NAIT-CNT-CMPE2750-1241-A02/SimonDemos/README.md

# SimonDemos
Demos used in this course, including the sample project.
