NAIT-CNT-CMPE2750-1241-A02/SimonDemos/design/pcb_design/die_roller_schematic.pdf

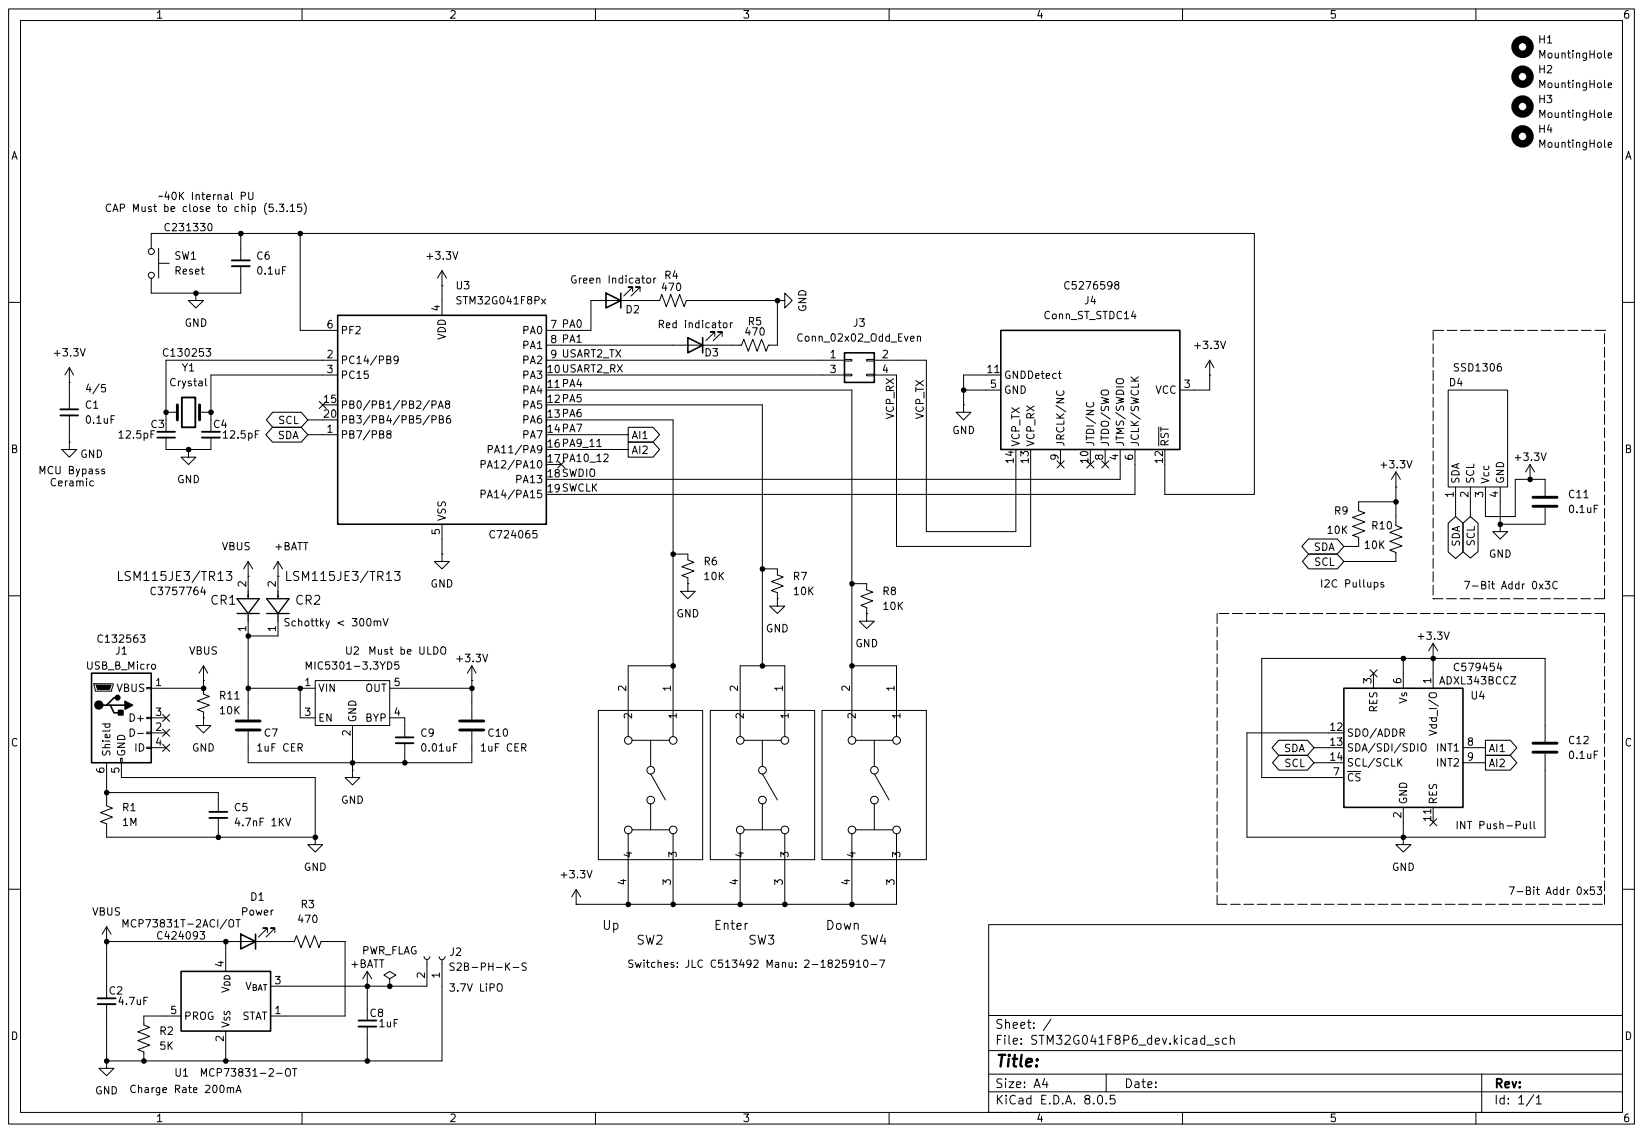
[picture p1: page 1]
