NAIT-CNT-CMPE2750-1241-A02/SimonDemos/design/pcb_design/STM32G041F8P6_dev.kicad_pcb

## KiCad design design/pcb_design/STM32G041F8P6_dev.kicad_pcb (2024-11-06)

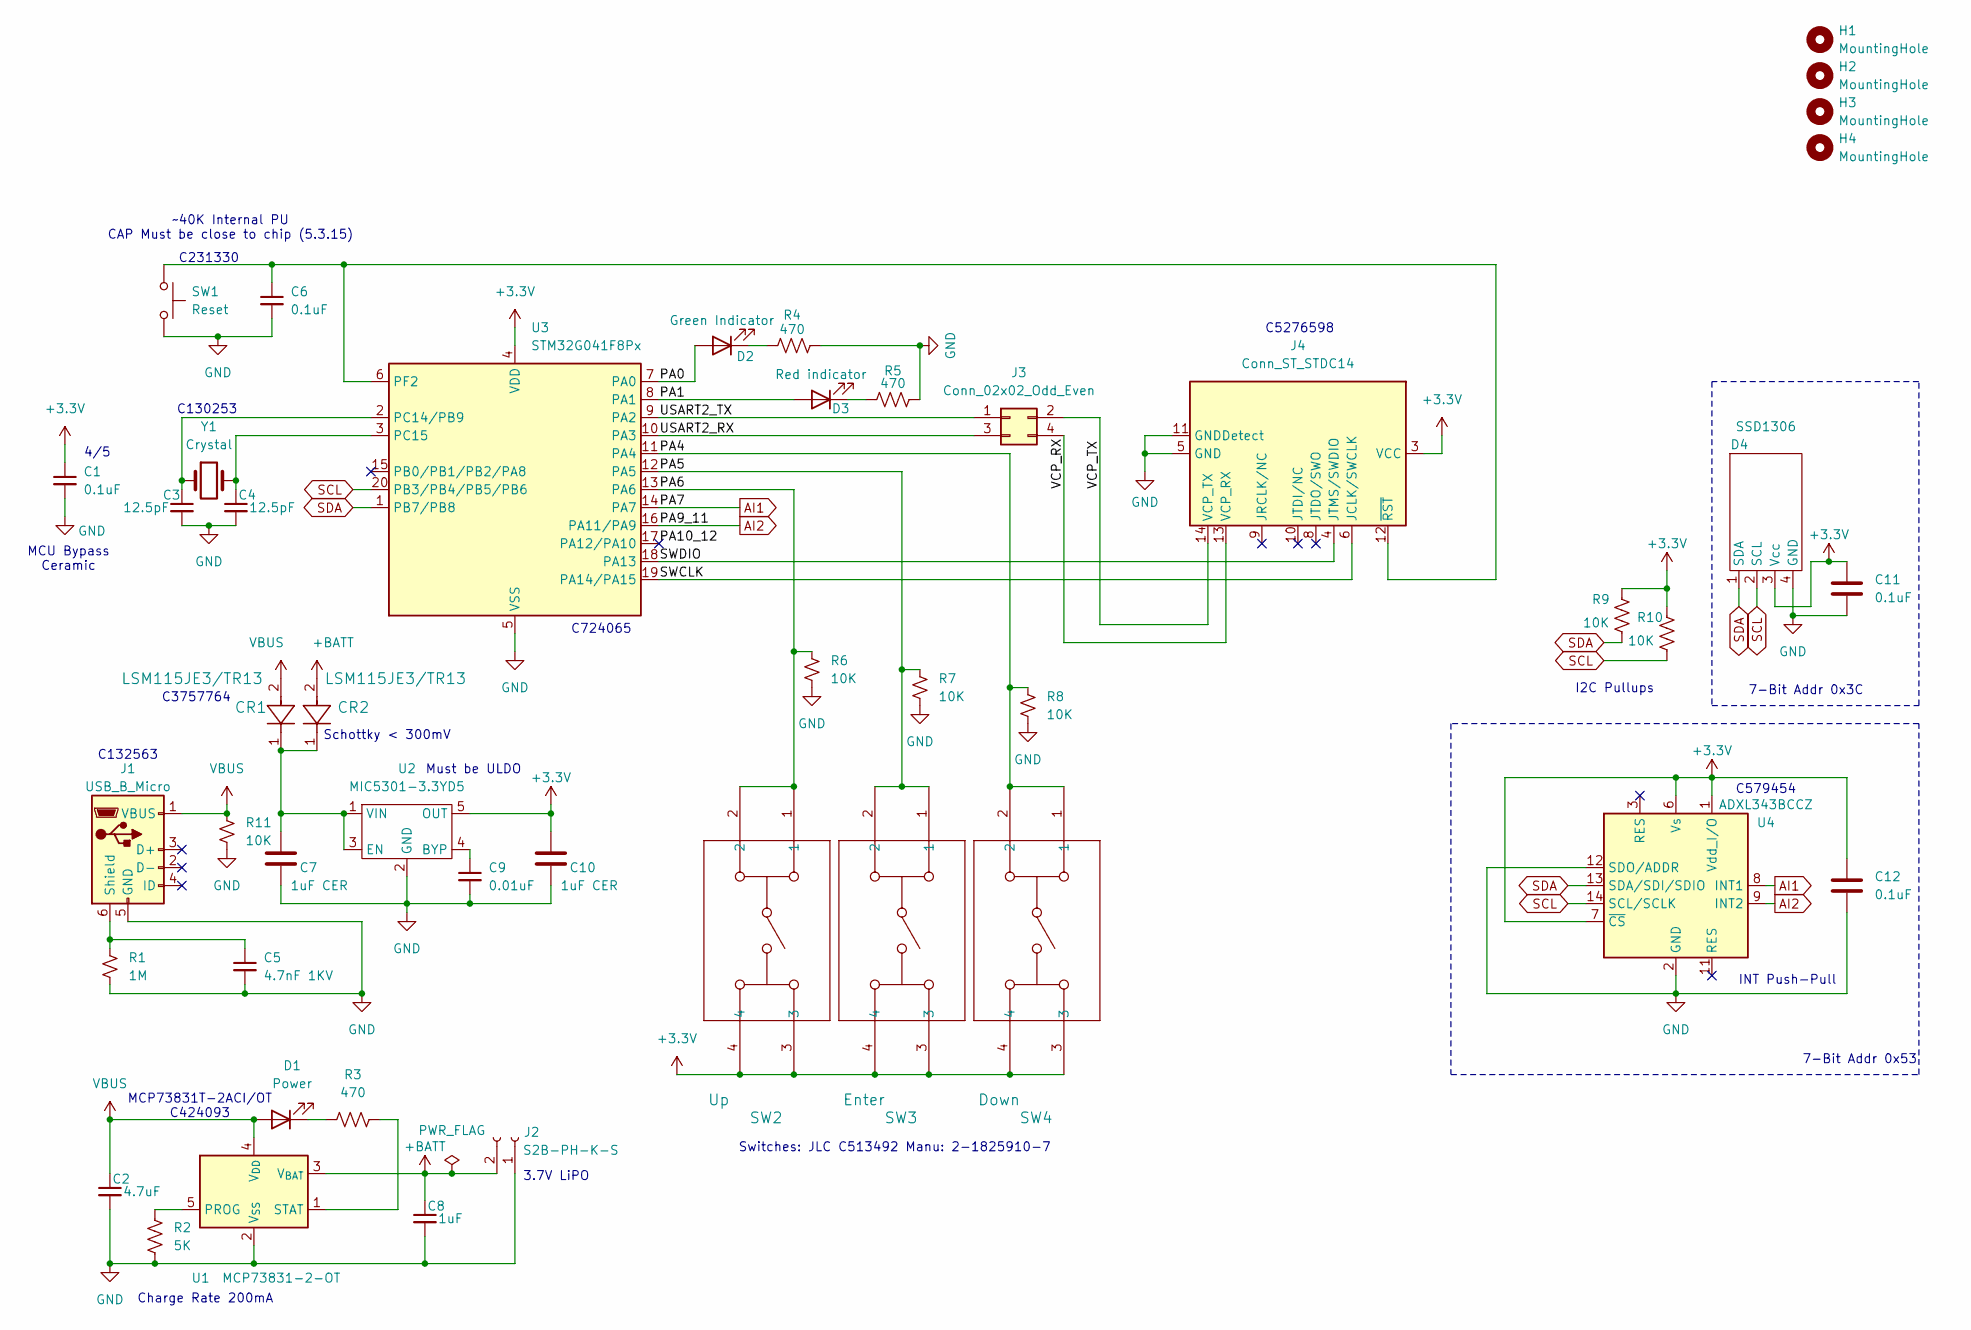
[picture p2: schematic STM32G041F8P6_dev.kicad_sch]

Parts:
C1, C6, C11, C12: 0.1uF; C_0603_1608Metric
C2: 4.7uF; C_1206_3216Metric
C3, C4: 12.5pF; C_0603_1608Metric
C5: 4.7nF 1KV; C_0805_2012Metric
C7, C10: 1uF CER; C_1206_3216Metric
C8: 1uF; C_1206_3216Metric
C9: 0.01uF; C_0805_2012Metric
CR1, CR2: LSM115JE3/TR13; DO-214BA_MCH
D1: Power; LED_0805_2012Metric
D2: Green Indicator; LED_0805_2012Metric
D3: Red indicator; LED_0805_2012Metric
D4: SSD1306; SmallOLED
H1, H2, H3, H4: MountingHole; MountingHole_3.2mm_M3
J1: USB_B_Micro; USB_Micro-B_Amphenol_10118194_Horizontal
J2: S2B-PH-K-S; JST_PH_S2B-PH-K_1x02_P2.00mm_Horizontal
J3: Conn_02x02_Odd_Even; PinHeader_2x02_P2.54mm_Vertical
J4: Conn_ST_STDC14; PinHeader_2x07_P1.27mm_Vertical_SMD
R1: 1M; R_0805_2012Metric
R2: 5K; R_0805_2012Metric
R3, R4, R5: 470; R_0805_2012Metric
R6, R7, R8, R9, R10, R11: 10K; R_0805_2012Metric
SW1: Reset; SW_SPST_B3U-1000P
SW2: Up; SW4_1825910-G_TEC
SW3: Enter; SW4_1825910-G_TEC
SW4: Down; SW4_1825910-G_TEC
U1: MCP73831-2-OT; SOT-23-5
U2: MIC5301-3.3YD5; TSOT-23-5
U3: STM32G041F8Px; TSSOP-20_4.4x6.5mm_P0.65mm
U4: ADXL343BCCZ; LGA-14_3x5mm_P0.8mm_LayoutBorder1x6y
Y1: Crystal; Crystal_SMD_3215-2Pin_3.2x1.5mm

Connections:
+3.3V: C1.1, C10.2, C11.1, C12.1, D4.3 (Vcc), J4.3 (VCC), R9.2, R10.2, SW2.3, SW2.4, SW3.3, SW3.4, SW4.3, SW4.4, U2.5 (OUT), U3.4 (VDD), U4.1 (Vdd_I/O), U4.6 (Vs), U4.7 (~CS)
+BATT: C8.1, CR2.2, J2.2, U1.3 (V_{BAT})
/PA0: D2.2 (A), U3.7 (PA0)
/PA1: D3.2 (A), U3.8 (PA1)
/PA4: R8.2, SW4.1, SW4.2, U3.11 (PA4)
/PA5: R7.2, SW3.1, SW3.2, U3.12 (PA5)
/PA6: R6.2, SW2.1, SW2.2, U3.13 (PA6)
/PA10_12: U3.17 (PA12/PA10)
/SWCLK: J4.6 (JCLK/SWCLK), U3.19 (PA14/PA15)
/SWDIO: J4.4 (JTMS/SWDIO), U3.18 (PA13)
/USART2_RX: J3.3, U3.10 (PA3)
/USART2_TX: J3.1, U3.9 (PA2)
/VCP_RX: J3.4, J4.13 (VCP_RX)
/VCP_TX: J3.2, J4.14 (VCP_TX)
AI1: U3.14 (PA7), U4.8 (INT1)
AI2: U3.16 (PA11/PA9), U4.9 (INT2)
GND: C1.2, C2.2, C3.2, C4.2, C5.2, C6.2, C7.1, C8.2, C9.2, C10.1, C11.2, C12.2, D4.4 (GND), J1.5 (GND), J2.1, J4.5 (GND), J4.7 (GND), J4.11 (GNDDetect), R1.2, R2.2, R4.1, R5.1, R6.1, R7.1, R8.1, R11.1, SW1.2, U1.2 (V_{SS}), U2.2 (GND), U3.5 (VSS), U4.2 (GND), U4.4 (GND), U4.5 (GND), U4.12 (SDO/ADDR)
unnamed: D1.1 (K), R3.2
unnamed: D2.1 (K), R4.2
unnamed: D3.1 (K), R5.2
unnamed: C5.1, J1.6 (Shield), R1.1
unnamed: C6.1, J4.12 (~RST), SW1.1, U3.6 (PF2)
unnamed: R2.1, U1.5 (PROG)
unnamed: R3.1, U1.1 (STAT)
unnamed: C9.1, U2.4 (BYP)
unnamed: C7.2, CR1.1, CR2.1, U2.1 (VIN), U2.3 (EN)
unnamed: C3.1, U3.2 (PC14/PB9), Y1.1
unnamed: C4.1, U3.3 (PC15), Y1.2
SCL: D4.2 (SCL), R10.1, U3.20 (PB3/PB4/PB5/PB6), U4.14 (SCL/SCLK)
SDA: D4.1 (SDA), R9.1, U3.1 (PB7/PB8), U4.13 (SDA/SDI/SDIO)
VBUS: C2.1, CR1.2, D1.2 (A), J1.1 (VBUS), R11.2, U1.4 (V_{DD})

Notes on the sheet:
4/5
~40K Internal PU CAP Must be close to chip (5.3.15)
MCU Bypass Ceramic
3.7V LiPO
Charge Rate 200mA
I2C Pullups
Switches: JLC C513492 Manu: 2-1825910-7
C3757764
C5276598
C130253
C579454
MCP73831T-2ACI/OT C424093
INT Push-Pull
C724065
7-Bit Addr 0x3C
C132563
Must be ULDO
C231330
Schottky < 300mV
7-Bit Addr 0x53

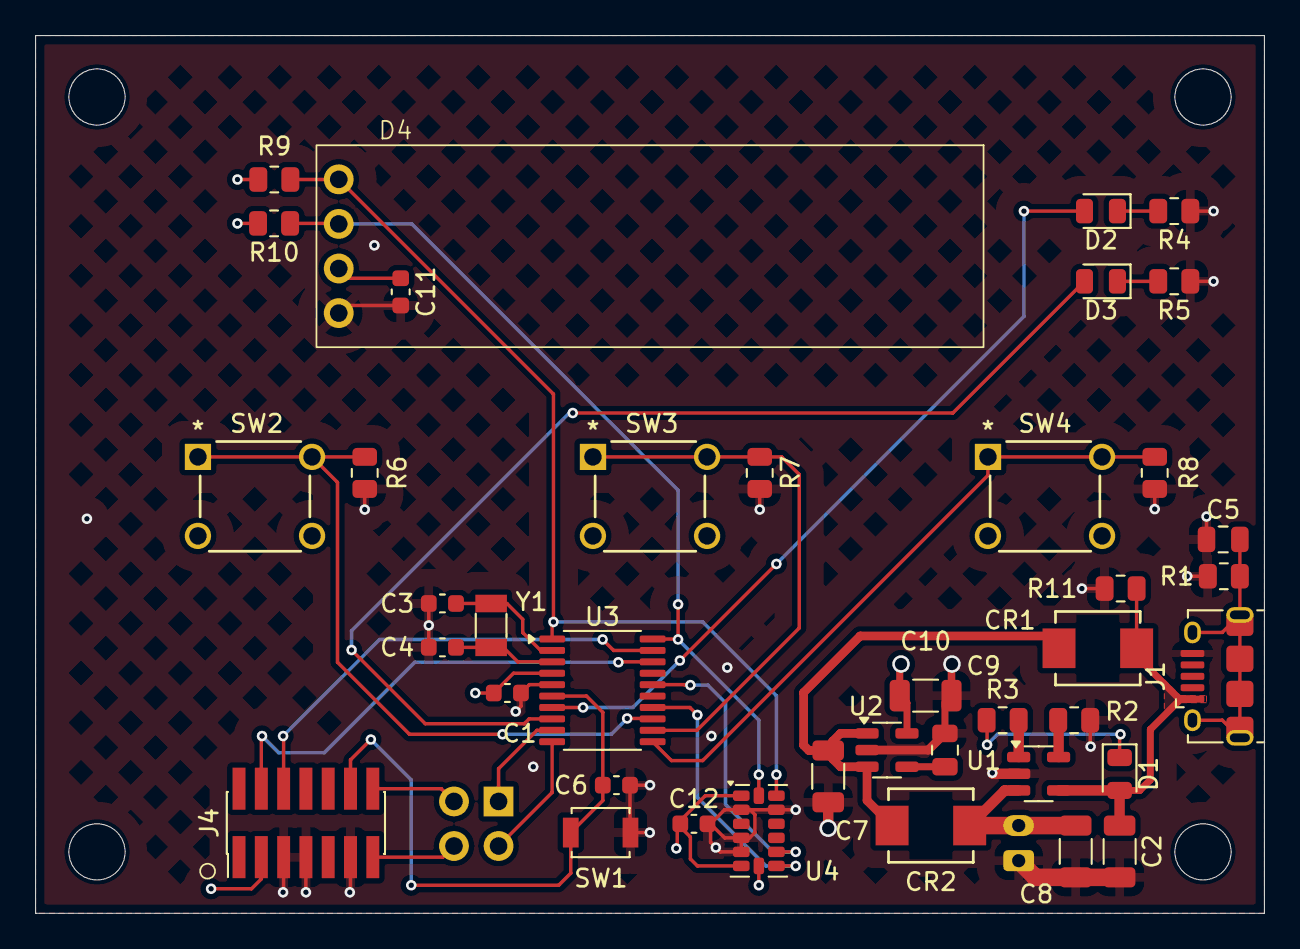
[picture p3: board STM32G041F8P6_dev.kicad_pcb from above]

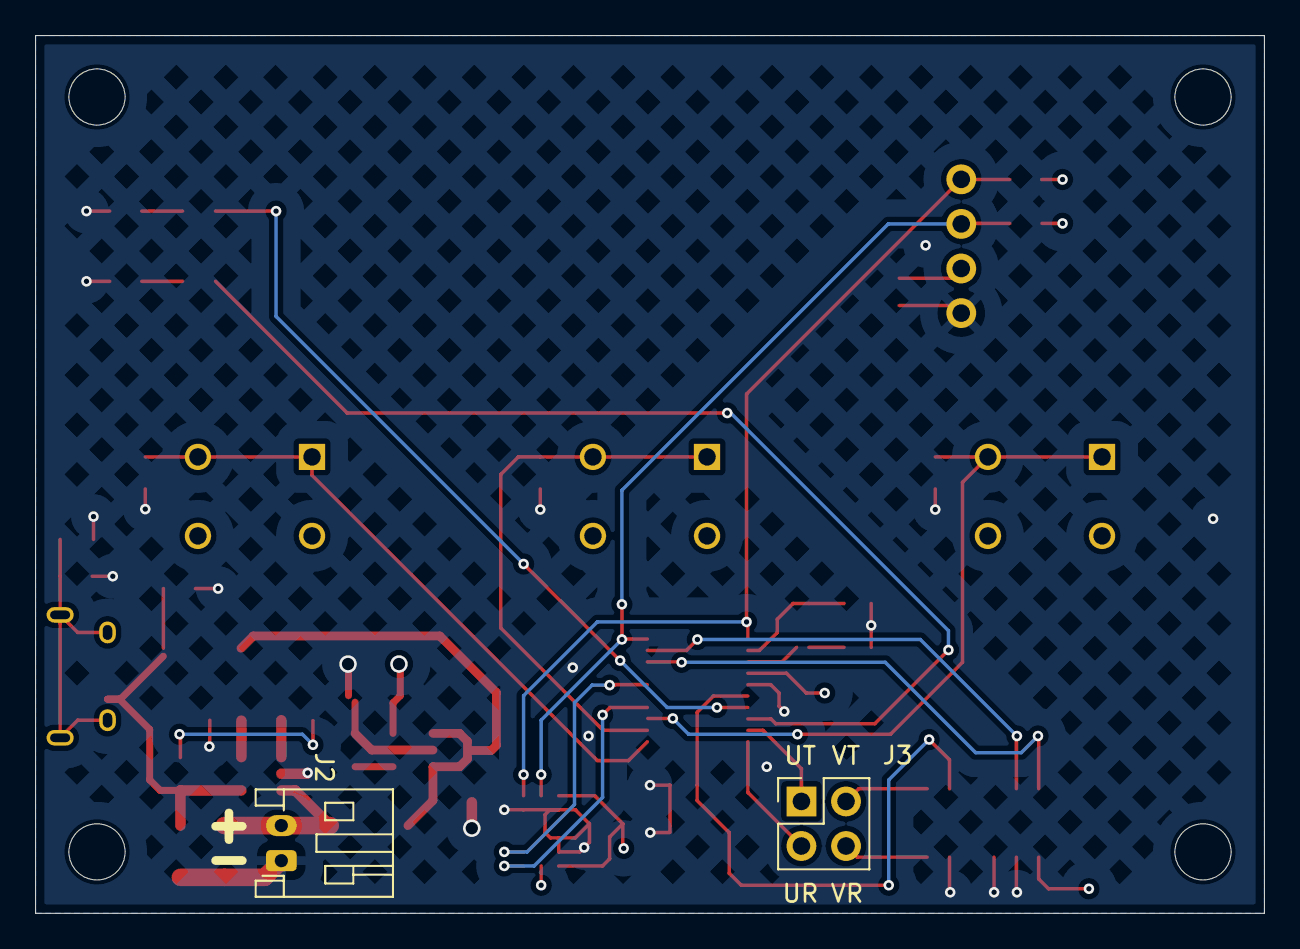
[picture p4: board STM32G041F8P6_dev.kicad_pcb from below]

Board: 4 copper layers, 70.0 x 50.0 mm, 46 parts (2 on the bottom side), 30 nets.
