NAIT-CNT-CMPE2750-1241-A02/SimonDemos/(commit log)

2024-09-10 added some minor research stuff, charger datasheet
2024-09-13 added mote detail to project
    [breadboard_design.kicad_pcb, breadboard_design.kicad_sch]
2024-09-24 updates to breadboard demo
    [breadboard_design.kicad_sch]
2024-10-16 added interrupt line to micro from SSSR1.8
    [breadboard_design.kicad_sch]
2024-10-24 updates to pcb
    [STM32G041F8P6_dev.kicad_pcb, STM32G041F8P6_dev.kicad_sch]
2024-10-24 pcb updates, initial layout
    [STM32G041F8P6_dev.kicad_pcb, STM32G041F8P6_dev.kicad_sch]
2024-10-24 pcb updates
    [STM32G041F8P6_dev.kicad_pcb, STM32G041F8P6_dev.kicad_sch]
2024-10-31 PCB Design Updates
    [STM32G041F8P6_dev.kicad_pcb, STM32G041F8P6_dev.kicad_sch]
2024-11-06 Final changes before manufacture.
    [STM32G041F8P6_dev-B_Cu.gbr, STM32G041F8P6_dev-B_Fab.gbr, STM32G041F8P6_dev-B_Mask.gbr, STM32G041F8P6_dev-B_Paste.gbr, STM32G041F8P6_dev-B_Silkscreen.gbr, STM32G041F8P6_dev-Edge_Cuts.gbr, STM32G041F8P6_dev-F_Cu.gbr, STM32G041F8P6_dev-F_Fab.gbr]
2025-09-24 added net labels
    [breadboard_design.kicad_sch]
